Tinkerforge/led-strip-bricklet/hardware/led-strip.step

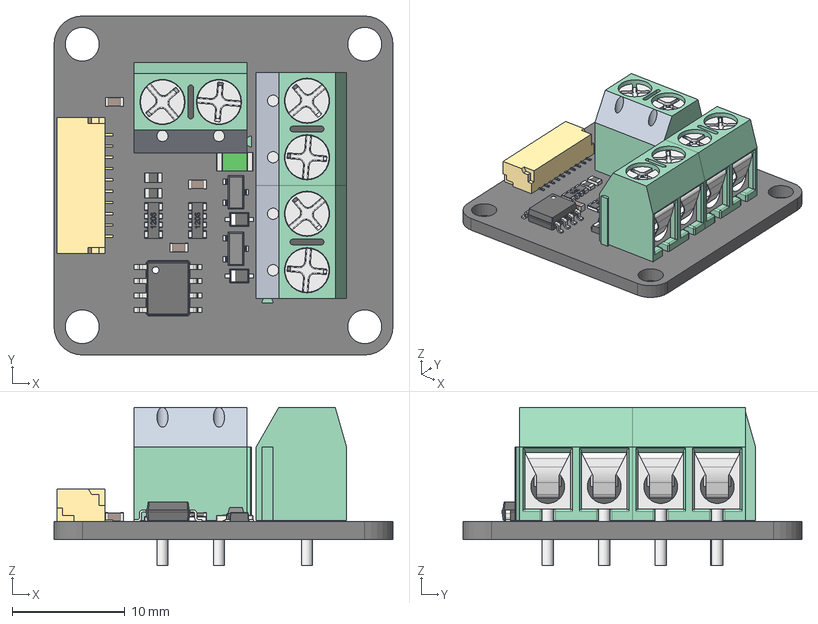
[picture p3: CAD file, 2017-07-31]
hardware/led-strip.step
30.0 x 30.0 x 14.0 mm
