Tinkerforge/led-strip-bricklet/(list of files, cad)

Other CAD files:
hardware/led-strip.FCStd
