Tinkerforge/led-strip-bricklet/hardware/led-strip-schematic.pdf

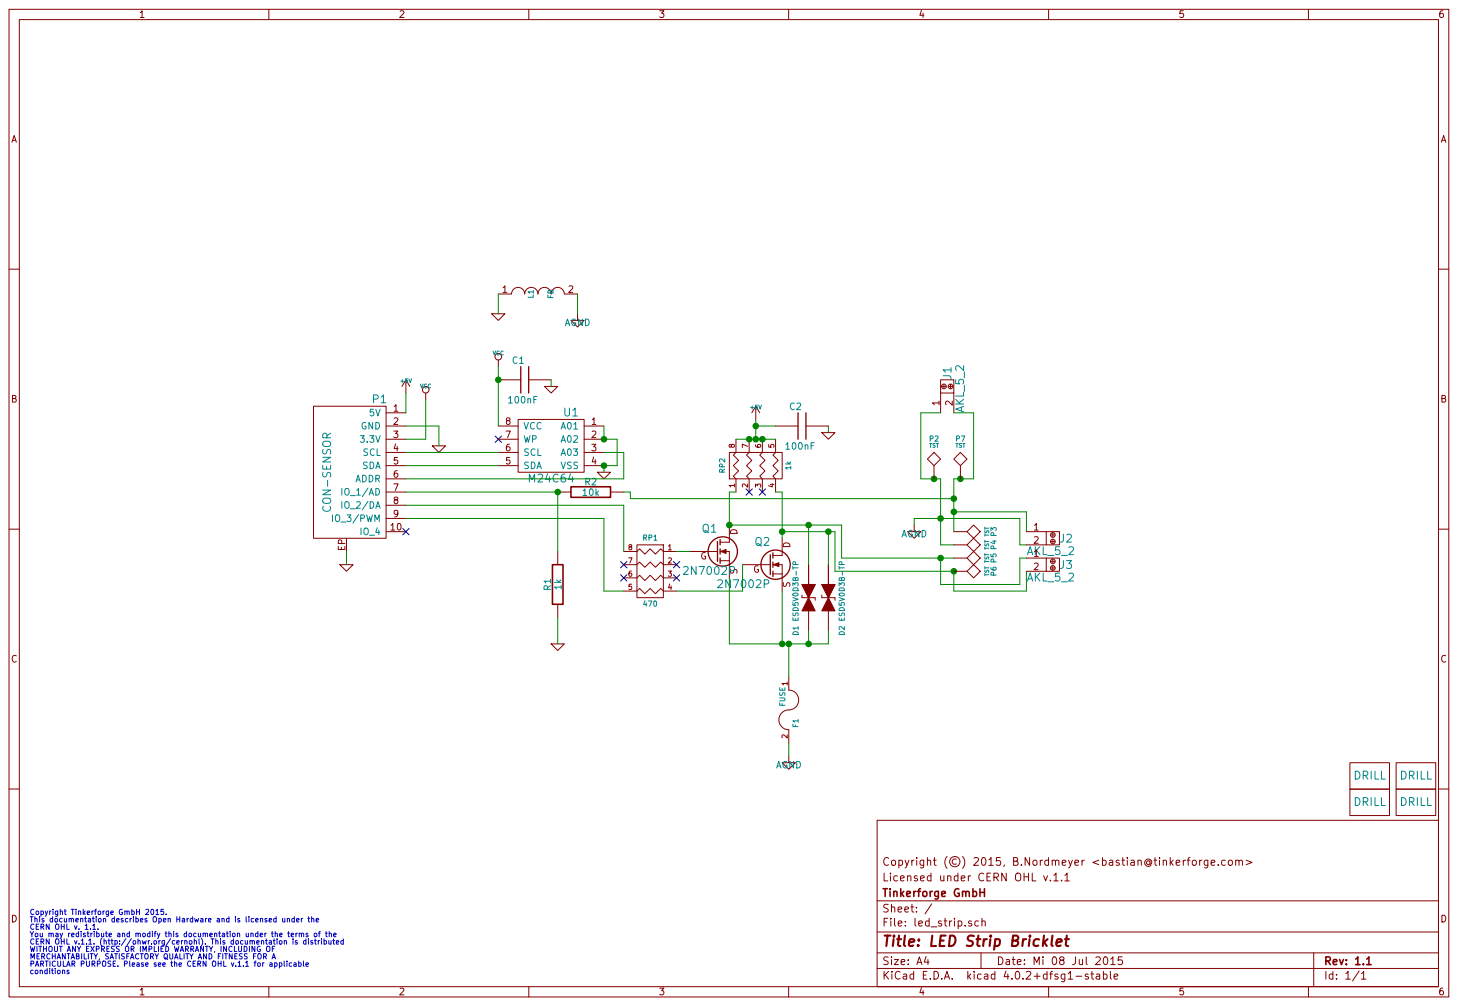
[picture p4: page 1]

Licensed under CERN OHL v.1.1 Copyright (©) 2015, B.Nordmeyer <bastian@tinkerforge.com>

File: led_strip.sch Sheet: / Tinkerforge GmbH

Copyright Tinkerforge GmbH 2015. This documentation describes Open Hardware and is licensed under the CERN OHL v. 1.1. You may redistribute and modify this documentation under the terms of the CERN OHL v.1.1. (http://ohwr.org/cernohl). This documentation is distributed WITHOUT ANY EXPRESS OR IMPLIED WARRANTY, INCLUDING OF MERCHANTABILITY, SATISFACTORY QUALITY AND FITNESS FOR A

Id: 1/1 Title: LED Strip Bricklet

PARTICULAR PURPOSE. Please see the CERN OHL v.1.1 for applicable
