Tinkerforge/led-strip-bricklet/hardware/led-strip.kicad_pcb

## KiCad design hardware/led-strip.kicad_pcb (2018-03-28)

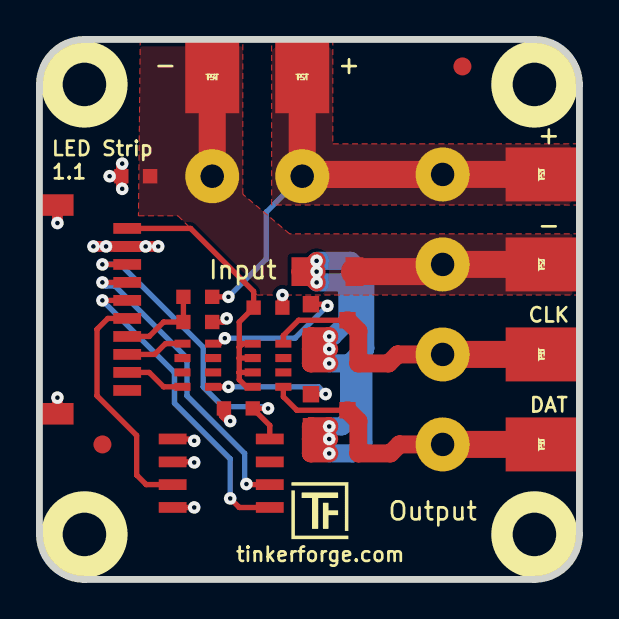
[picture p5: board led-strip.kicad_pcb from above]

Board: 2 copper layers, 30.0 x 30.0 mm, 31 parts (0 on the bottom side), 16 nets.

Parts:
C1, C2: 100nF; C0603
D1, D2: ESD5V0D3B-TP; SOD-323
F1: 0ZCJ0035FF2G; F1206
Fiducial_Mark: VAL**; Fiducial_Mark
Fiducial_Mark#2: VAL**; Fiducial_Mark
J1, J2, J3: AKL_5_2
L1: FB; C0603
P1: CON-SENSOR
P2, P3, P4, P5, P6, P7: TST; SOLDER_PAD2
Q1, Q2: 2N7002P; SOT23GDS
R1: 1k; R0603
R2: 10k; R0603
RP1: 470; 4X0603
RP2: 1k; 4X0603
U1: M24C64; SOIC8
U2, U3, U4, U5: DRILL; DRILL_NP
VAL: WEEE_7mm
VAL#2: CE_5mm

Connections:
+5V: C2.1, P1.1, RP2.5, RP2.6, RP2.7, RP2.8
AGND: F1.2, J1.1, J2.2, L1.2, P2.1, P4.1
GND: C1.2, C2.2, L1.1, P1.2, P1.EP, R1.1, U1.1, U1.2, U1.4
unnamed: D1.1, J3.1, P5.1, Q1.D, RP2.1
unnamed: D1.2, D2.2, F1.1, Q1.S, Q2.S
unnamed: D2.1, J3.2, P6.1, Q2.D, RP2.4
unnamed: J1.2, J2.1, P3.1, P7.1, R2.2
unnamed: P1.4, U1.6
unnamed: P1.5, U1.5
unnamed: P1.6, U1.3
unnamed: P1.7, R1.2, R2.1
unnamed: P1.8, RP1.8
unnamed: P1.9, RP1.5
unnamed: Q1.G, RP1.1
unnamed: Q2.G, RP1.4
VCC: C1.1, P1.3, U1.8
