Tinkerforge/led-strip-bricklet/software/src/led-strip.h

/* led-strip-bricklet
 * Copyright (C) 2013-2014 Olaf Lüke <olaf@tinkerforge.com>
 *
 * led-strip.h: Implementation of LED Strip Bricklet messages
 *
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
 * You should have received a copy of the GNU Lesser General Public
 * License along with this library; if not, write to the
 * Free Software Foundation, Inc., 59 Temple Place - Suite 330,
 * Boston, MA 02111-1307, USA.
 */

#ifndef LED_STRIP_H
#define LED_STRIP_H

#include <stdint.h>
#include "bricklib/com/com_common.h"

#define I2C_EEPROM_ADDRESS_HIGH 84

#define BUFFER_LENGTH 240
#define RGB_VALUE_SIZE 16
#define RGBW_VALUE_SIZE 12

#define TYPE_WS2801  0
#define TYPE_WS2811  1
#define TYPE_WS2812  2
#define TYPE_LPD8806 3
#define TYPE_APA102  4

#define CHANNEL_MAPPING_C3(c0, c1, c2)     (((c0) << 4) | ((c1) << 2) | (c2))
#define CHANNEL_MAPPING_C4(c0, c1, c2, c3) (((c0) << 6) | ((c1) << 4) | ((c2) << 2) | (c3))

#define CHANNEL_MAPPING_RGB  CHANNEL_MAPPING_C3(0, 1, 2)
#define CHANNEL_MAPPING_RBG  CHANNEL_MAPPING_C3(0, 2, 1)
#define CHANNEL_MAPPING_BRG  CHANNEL_MAPPING_C3(2, 0, 1)
#define CHANNEL_MAPPING_BGR  CHANNEL_MAPPING_C3(2, 1, 0)
#define CHANNEL_MAPPING_GRB  CHANNEL_MAPPING_C3(1, 0, 2)
#define CHANNEL_MAPPING_GBR  CHANNEL_MAPPING_C3(1, 2, 0)
#define CHANNEL_MAPPING_RGBW CHANNEL_MAPPING_C4(0, 1, 2, 3)
#define CHANNEL_MAPPING_RGWB CHANNEL_MAPPING_C4(0, 1, 3, 2)
#define CHANNEL_MAPPING_RBGW CHANNEL_MAPPING_C4(0, 2, 1, 3)
#define CHANNEL_MAPPING_RBWG CHANNEL_MAPPING_C4(0, 2, 3, 1)
#define CHANNEL_MAPPING_RWGB CHANNEL_MAPPING_C4(0, 3, 1, 2)
#define CHANNEL_MAPPING_RWBG CHANNEL_MAPPING_C4(0, 3, 2, 1)
#define CHANNEL_MAPPING_GRWB CHANNEL_MAPPING_C4(1, 0, 3, 2)
#define CHANNEL_MAPPING_GRBW CHANNEL_MAPPING_C4(1, 0, 2, 3)
#define CHANNEL_MAPPING_GBWR CHANNEL_MAPPING_C4(1, 2, 3, 0)
#define CHANNEL_MAPPING_GBRW CHANNEL_MAPPING_C4(1, 2, 0, 3)
#define CHANNEL_MAPPING_GWBR CHANNEL_MAPPING_C4(1, 3, 2, 0)
#define CHANNEL_MAPPING_GWRB CHANNEL_MAPPING_C4(1, 3, 0, 2)
#define CHANNEL_MAPPING_BRGW CHANNEL_MAPPING_C4(2, 0, 1, 3)
#define CHANNEL_MAPPING_BRWG CHANNEL_MAPPING_C4(2, 0, 3, 1)
#define CHANNEL_MAPPING_BGRW CHANNEL_MAPPING_C4(2, 1, 0, 3)
#define CHANNEL_MAPPING_BGWR CHANNEL_MAPPING_C4(2, 1, 3, 0)
#define CHANNEL_MAPPING_BWRG CHANNEL_MAPPING_C4(2, 3, 0, 1)
#define CHANNEL_MAPPING_BWGR CHANNEL_MAPPING_C4(2, 3, 1, 0)
#define CHANNEL_MAPPING_WRBG CHANNEL_MAPPING_C4(3, 0, 2, 1)
#define CHANNEL_MAPPING_WRGB CHANNEL_MAPPING_C4(3, 0, 1, 2)
#define CHANNEL_MAPPING_WGBR CHANNEL_MAPPING_C4(3, 1, 2, 0)
#define CHANNEL_MAPPING_WGRB CHANNEL_MAPPING_C4(3, 1, 0, 2)
#define CHANNEL_MAPPING_WBGR CHANNEL_MAPPING_C4(3, 2, 1, 0)
#define CHANNEL_MAPPING_WBRG CHANNEL_MAPPING_C4(3, 2, 0, 1)

#define OPTION_TYPE_MASK        (7 << 1)

#define OPTION_FRAME_RENDERED   (1 << 0)
#define OPTION_TYPE_WS2801      (TYPE_WS2801 << 1)
#define OPTION_TYPE_WS2811      (TYPE_WS2811 << 1)
#define OPTION_TYPE_WS2812      (TYPE_WS2812 << 1)
#define OPTION_TYPE_LPD8806     (TYPE_LPD8806 << 1)
#define OPTION_TYPE_APA102      (TYPE_APA102 << 1)
#define OPTION_DATA_CHANGED     (1 << 4)
#define OPTION_DATA_ONE_MORE    (1 << 5)
#define OPTION_4_CHANNELS       (1 << 6)
#define OPTION_CALLBACK_ENABLED (1 << 7)

#define FID_SET_RGB_VALUES      1
#define FID_GET_RGB_VALUES      2
#define FID_SET_FRAME_DURATION  3
#define FID_GET_FRAME_DURATION  4
#define FID_GET_SUPPLY_VOLTAGE  5
#define FID_FRAME_RENDERED      6
#define FID_SET_CLOCK_FREQUENCY 7
#define FID_GET_CLOCK_FREQUENCY 8
#define FID_SET_CHIP_TYPE       9
#define FID_GET_CHIP_TYPE       10
#define FID_SET_RGBW_VALUES     11
#define FID_GET_RGBW_VALUES     12
#define FID_SET_CHANNEL_MAPPING 13
#define FID_GET_CHANNEL_MAPPING 14
#define FID_ENABLE_FRAME_RENDERED_CALLBACK     15
#define FID_DISABLE_FRAME_RENDERED_CALLBACK    16
#define FID_IS_FRAME_RENDERED_CALLBACK_ENABLED 17

#define BYTES_1   8
#define BYTES_3  24
#define BYTES_4  32

typedef struct {
	MessageHeader header;
	uint16_t index;
	uint8_t length;
	uint8_t r[RGB_VALUE_SIZE];
	uint8_t g[RGB_VALUE_SIZE];
	uint8_t b[RGB_VALUE_SIZE];
} __attribute__((__packed__)) SetRGBValues;

typedef struct {
	MessageHeader header;
	uint16_t index;
	uint8_t length;
} __attribute__((__packed__)) GetRGBValues;

typedef struct {
	MessageHeader header;
	uint8_t r[RGB_VALUE_SIZE];
	uint8_t g[RGB_VALUE_SIZE];
	uint8_t b[RGB_VALUE_SIZE];
} __attribute__((__packed__)) GetRGBValuesReturn;

typedef struct {
	MessageHeader header;
	uint16_t duration;
} __attribute__((__packed__)) SetFrameDuration;

typedef struct {
	MessageHeader header;
} __attribute__((__packed__)) GetFrameDuration;

typedef struct {
	MessageHeader header;
	uint16_t duration;
} __attribute__((__packed__)) GetFrameDurationReturn;

typedef struct {
	MessageHeader header;
} __attribute__((__packed__)) GetSupplyVoltage;

typedef struct {
	MessageHeader header;
	uint16_t voltage;
} __attribute__((__packed__)) GetSupplyVoltageReturn;

typedef struct {
	MessageHeader header;
	uint16_t length;
} __attribute__((__packed__)) FrameRendered;

typedef struct {
	MessageHeader header;
	uint32_t frequency;
} __attribute__((__packed__)) SetClockFrequency;

typedef struct {
	MessageHeader header;
} __attribute__((__packed__)) GetClockFrequency;

typedef struct {
	MessageHeader header;
	uint32_t frequency;
} __attribute__((__packed__)) GetClockFrequencyReturn;

typedef struct {
	MessageHeader header;
	uint16_t chip;
} __attribute__((__packed__)) SetChipType;

typedef struct {
	MessageHeader header;
} __attribute__((__packed__)) GetChipType;

typedef struct {
	MessageHeader header;
	uint16_t chip;
} __attribute__((__packed__)) GetChipTypeReturn;

typedef struct {
	MessageHeader header;
	uint16_t index;
	uint8_t length;
	uint8_t r[RGBW_VALUE_SIZE];
	uint8_t g[RGBW_VALUE_SIZE];
	uint8_t b[RGBW_VALUE_SIZE];
	uint8_t w[RGBW_VALUE_SIZE];
} __attribute__((__packed__)) SetRGBWValues;

typedef struct {
	MessageHeader header;
	uint16_t index;
	uint8_t length;
} __attribute__((__packed__)) GetRGBWValues;

typedef struct {
	MessageHeader header;
	uint8_t r[RGBW_VALUE_SIZE];
	uint8_t g[RGBW_VALUE_SIZE];
	uint8_t b[RGBW_VALUE_SIZE];
	uint8_t w[RGBW_VALUE_SIZE];
} __attribute__((__packed__)) GetRGBWValuesReturn;

typedef struct {
	MessageHeader header;
	uint8_t channel_mapping;
} __attribute__((__packed__)) SetChannelMapping;

typedef struct {
	MessageHeader header;
} __attribute__((__packed__)) GetChannelMapping;

typedef struct {
	MessageHeader header;
	uint8_t channel_mapping;
} __attribute__((__packed__)) GetChannelMappingReturn;

typedef struct {
	MessageHeader header;
} __attribute__((__packed__)) EnableFrameRenderedCallback;

typedef struct {
	MessageHeader header;
} __attribute__((__packed__)) DisableFrameRenderedCallback;

typedef struct {
	MessageHeader header;
} __attribute__((__packed__)) IsFrameRenderedCallbackEnabled;

typedef struct {
	MessageHeader header;
	bool enabled;
} __attribute__((__packed__)) IsFrameRenderedCallbackEnabledReturn;

void set_rgb_values(const ComType com, const SetRGBValues *data);
void get_rgb_values(const ComType com, const GetRGBValues *data);
void set_frame_duration(const ComType com, const SetFrameDuration *data);
void get_frame_duration(const ComType com, const GetFrameDuration *data);
void get_supply_voltage(const ComType com, const GetSupplyVoltage *data);
void set_clock_frequency(const ComType com, const SetClockFrequency *data);
void get_clock_frequency(const ComType com, const GetClockFrequency *data);
void set_chip_type(const ComType com, const SetChipType *data);
void get_chip_type(const ComType com, const GetChipType *data);
void set_rgbw_values(const ComType com, const SetRGBWValues *data);
void get_rgbw_values(const ComType com, const GetRGBWValues *data);
void set_channel_mapping(const ComType com, const SetChannelMapping *data);
void get_channel_mapping(const ComType com, const GetChannelMapping *data);
void enable_frame_rendered_callback(const ComType com, const EnableFrameRenderedCallback *data);
void disable_frame_rendered_callback(const ComType com, const DisableFrameRenderedCallback *data);
void is_frame_rendered_callback_enabled(const ComType com, const IsFrameRenderedCallbackEnabled *data);

void bb_write_ws281x(const uint32_t value, const int8_t byteCount);
void bb_write_withClock(const uint32_t value, const int8_t byteCount);

void option_ws2801(void);
void option_ws281x(void);
void option_lpd8806(void);
void option_apa102(void);

void set_rgb_by_global_index(uint16_t index, uint8_t *rgb);
void get_rgb_from_global_index(uint16_t index, uint8_t *rgb);

void set_rgbw_by_global_index(uint16_t index, uint8_t *rgbw);
void get_rgbw_from_global_index(uint16_t index, uint8_t *rgbw);

void invocation(const ComType com, const uint8_t *data);
void constructor(void);
void destructor(void);
void tick(const uint8_t tick_type);

#endif
