Tinkerforge/led-strip-bricklet/(commit log)

2013-10-15 add hardware files
    [led_strip.kicad_pcb, led_strip.sch]
2013-10-29 Fix variable type in loop (we need uint16 instead of uint8)
    [led-strip.c]
2013-10-30 Add missing LED Strip examples for ruby and python
2013-10-30 Don't use data in case of error
    [led-strip.c]
2013-11-19 update schematic to correct resistor values
2013-11-19 update hardware files with new resistor values
    [led_strip.kicad_pcb, led_strip.sch]
2014-01-14 perl: Fix warning about unsharing the $led_strip variable
2014-02-10 Perl Example Modified: LED Strip Bricklet callback
2014-04-02 perl: Unify print style
2014-07-22 * Frame duration of 0 now means that no more frames shall be set * Set RGB values at least two times to make sure that they are really written * Fix possible overflow if Brick with two Bricklet conne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
    [config.h, led-strip.c, led-strip.h]
2015-07-08 new prototype of led strip bricklet
    [led_strip.kicad_pcb, led_strip.sch]
2015-08-07 Use full device class name in Python examples
2015-09-25 drc run
    [led_strip.kicad_pcb]
2016-05-18 c: Add missing device destroy call
2016-08-01 Add brightness control for APA102
    Does not work with Master Brick FW 2.4.0
    [led-strip.c, led-strip.h]
2016-09-02 Apply channel mapping in RGB(W) getter
    Restructure buffer handling to reduce code size.
    Alos fix frame_max_length calculation in RGBW mode.
    [config.h, led-strip.c, led-strip.h]
2016-09-02 Add missing APA102 endframe
    [led-strip.c]
2016-09-02 Fix default channel mapping
    [led-strip.c]
2016-09-02 Fix loop in RGB(W) getters
    [led-strip.c]
2016-09-02 Send correct number of zero bytes for LPD8806
    [led-strip.c]
2016-09-06 Make channel mapping constants contain the actual mapping table
    Also store channels unmapped and map them before sending to the LEDs.
    This allows to change the mapping for already set RGB(W) values.
2016-09-06 Add option to disable frame-rendered callback
2016-09-06 Add missing setter return
    [led-strip.c]
2016-09-07 Fix green flash after reset
    MOSFET inverts logic, initial pin state needs to be high to ensure low
    output until first frame.
    [led-strip.c]
2017-07-31 Fix broken symbols
    [led_strip.sch]
2017-07-31 New schematic version
2017-07-31 Add 3d information (final)
    [led_strip.kicad_pcb, led_strip.sch]
2017-07-31 Add 3d model (*.step & *.FCStd)
    [led_strip.FCStd, led_strip.step]
2018-02-20 Cleanup KiCad libraries config
    Ensure LibDir=kicad-libraries and LibName1=tinkerforge.
    Remove special library.
2018-03-28 specify fuse
    [led_strip.kicad_pcb, led_strip.sch]
2018-05-11 Rename files
    [led-strip.FCStd, led-strip.kicad_pcb, led-strip.sch, led-strip.step]
2021-10-25 Update KiCad link
    https://www.kicad.org/blog/2021/10/Avoid-links-to-former-kicad-domain/
