Tinkerforge/led-strip-bricklet/(notices)

Notices in the files:
hardware/led-strip.kicad_pcb:
Copyright Tinkerforge GmbH 2013.
